cherry-takuan/SST39SF010A-Writer/README.md

# SST39SF010A-Writer
SST39SF010A Reader/Writer
