cherry-takuan/SST39SF010A-Writer/src/README.md

# Flash Bakery
フラッシュメモリ書き込みソフト
まだバグだらけな上に，機能を選択できる癖に未実装な部分がたくさんあります。

`cliand/main.py`を実行すれば立ち上がります。

書き込みデバイス「Flash Baker」とは専用の通信規格で接続されます。

# Baker通信規格

## アドレス設定
@コマンドを使用し，1～6文字の16進数値で操作先のアドレスを設定
レスポンスは移動したアドレス

- command : `@XXXXXX[LF]`
- response : `XXXXXX[LF]`

## データリード
Rコマンドを使用し，読み取り
アドレスは＠コマンドで指定
レスポンスはアドレスの値を2文字の16進数値
- command : `R[LF]`
- response : `XX[LF]`
  
## データライト
Wコマンドを使用し，1～2文字の16進数値で書き込みデータを指定
アドレスは＠コマンドで指定
レスポンスはアドレスの値を2文字の16進数値
- command : `WXX[LF]`
- response : `XX[LF]`

## セクターイレース
Dコマンドを使用し，セクター削除
セクター番号は値を2文字の16進数値で表現
レスポンスは成功で0を返却
- command : `DXX[LF]`
- response : `0[LF]`

## チップイレース
Dコマンドを使用し，全体削除
レスポンスは成功で0を返却
- command : `D[LF]`
- response : `0[LF]`
