cherry-takuan/SST39SF010A-Writer/(commit log)

2025-02-08 ROMライタハードウェア完成
    [ROM_Writer.kicad_pcb, ROM_Writer.kicad_sch, bom.csv, designators.csv, positions.csv]
2025-02-16 ROMの読み書き削除のインターフェイス
2025-02-16 クライアントアプリFlash Bakeryの雛型
